kokhaie/Smart-Refrigerator-Demo/PCB/README.md

# PCB Bill of Materials

The KiCad-generated BOM is mirrored into the documentation site under `docs/` so it can be published through GitHub Pages.

- **Live BOM:** https://kokhaie.github.io/Smart-Refrigerator-Demo/bom.html
