kokhaie/Smart-Refrigerator-Demo/DataSheets/51OYClzEd8L._SL1000_.jpg

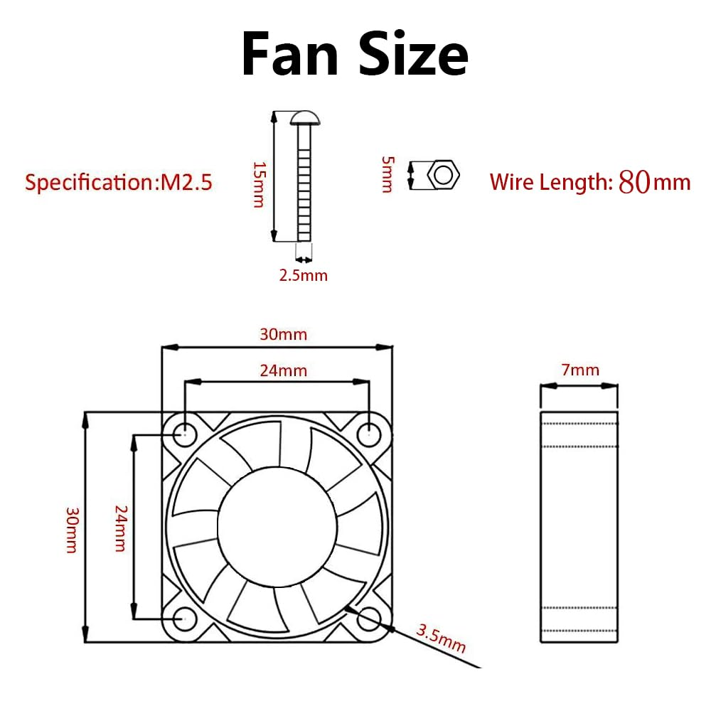
DataSheets/51OYClzEd8L._SL1000_.jpg
