kokhaie/Smart-Refrigerator-Demo/Firmware/components/lcd_manager/assets/images/mockups/lcd_dashboard.png

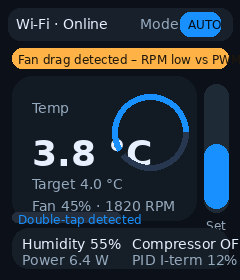
Firmware/components/lcd_manager/assets/images/mockups/lcd_dashboard.png
