kokhaie/Smart-Refrigerator-Demo/Firmware/components/lcd_manager/assets/images/mockups/lcd_landscape_home.png

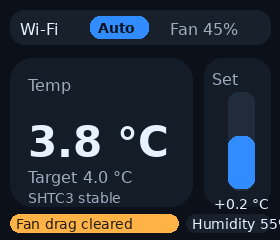
Firmware/components/lcd_manager/assets/images/mockups/lcd_landscape_home.png
