kokhaie/Smart-Refrigerator-Demo/Enclosure/front.dxf

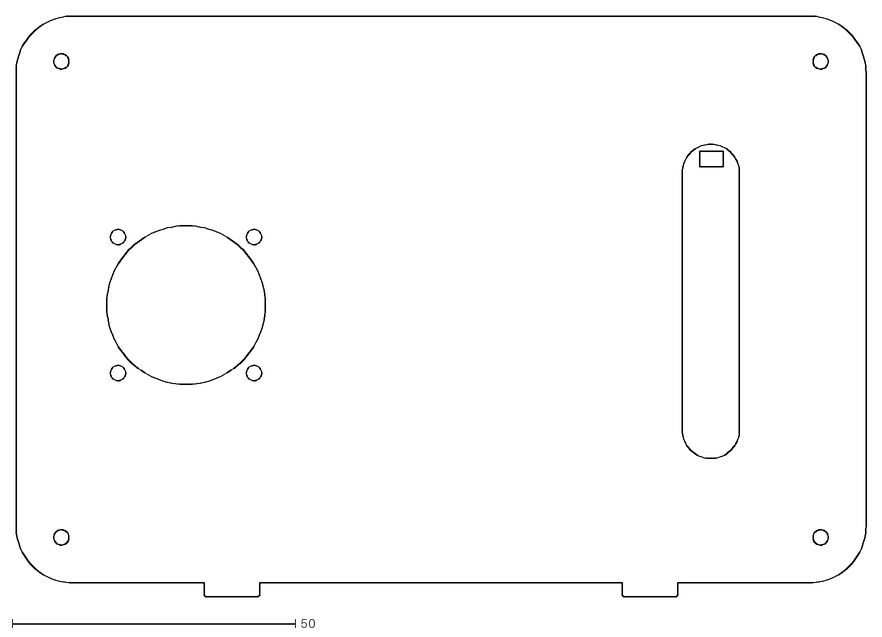
[picture p6: CAD file, 2025-10-21]
Enclosure/front.dxf
150.0 x 102.5
