kokhaie/Smart-Refrigerator-Demo/Enclosure/back.dxf

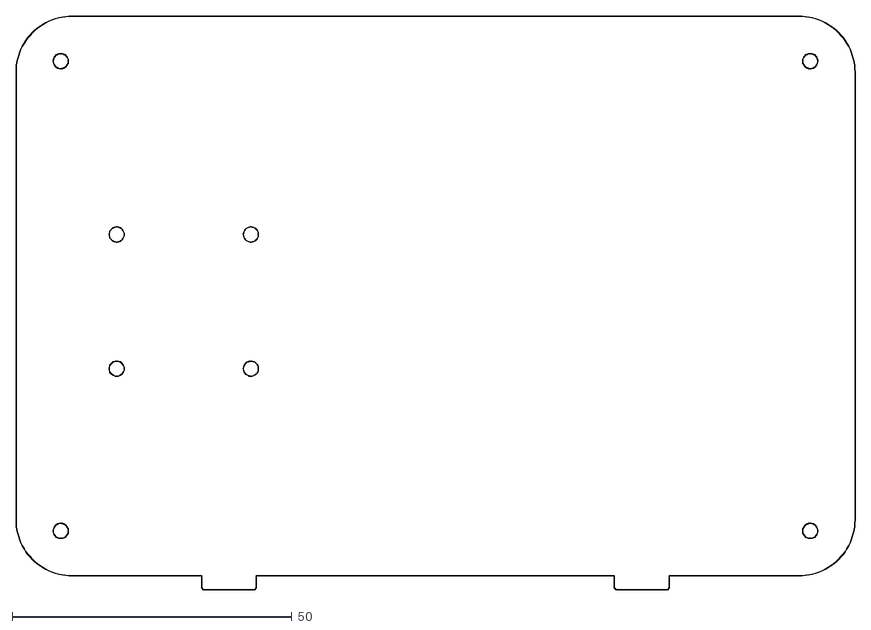
[picture p7: CAD file, 2025-10-21]
Enclosure/back.dxf
150.0 x 102.5
