kokhaie/Smart-Refrigerator-Demo/Enclosure/bottom.dxf

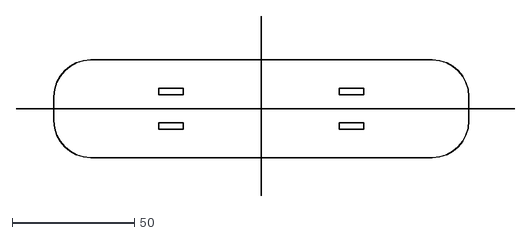
[picture p8: CAD file, 2025-10-21]
Enclosure/bottom.dxf
204.3 x 73.6
