kokhaie/Smart-Refrigerator-Demo/PCB/SmartCube.kicad_pcb

## KiCad design PCB/SmartCube.kicad_pcb (2025-09-15)

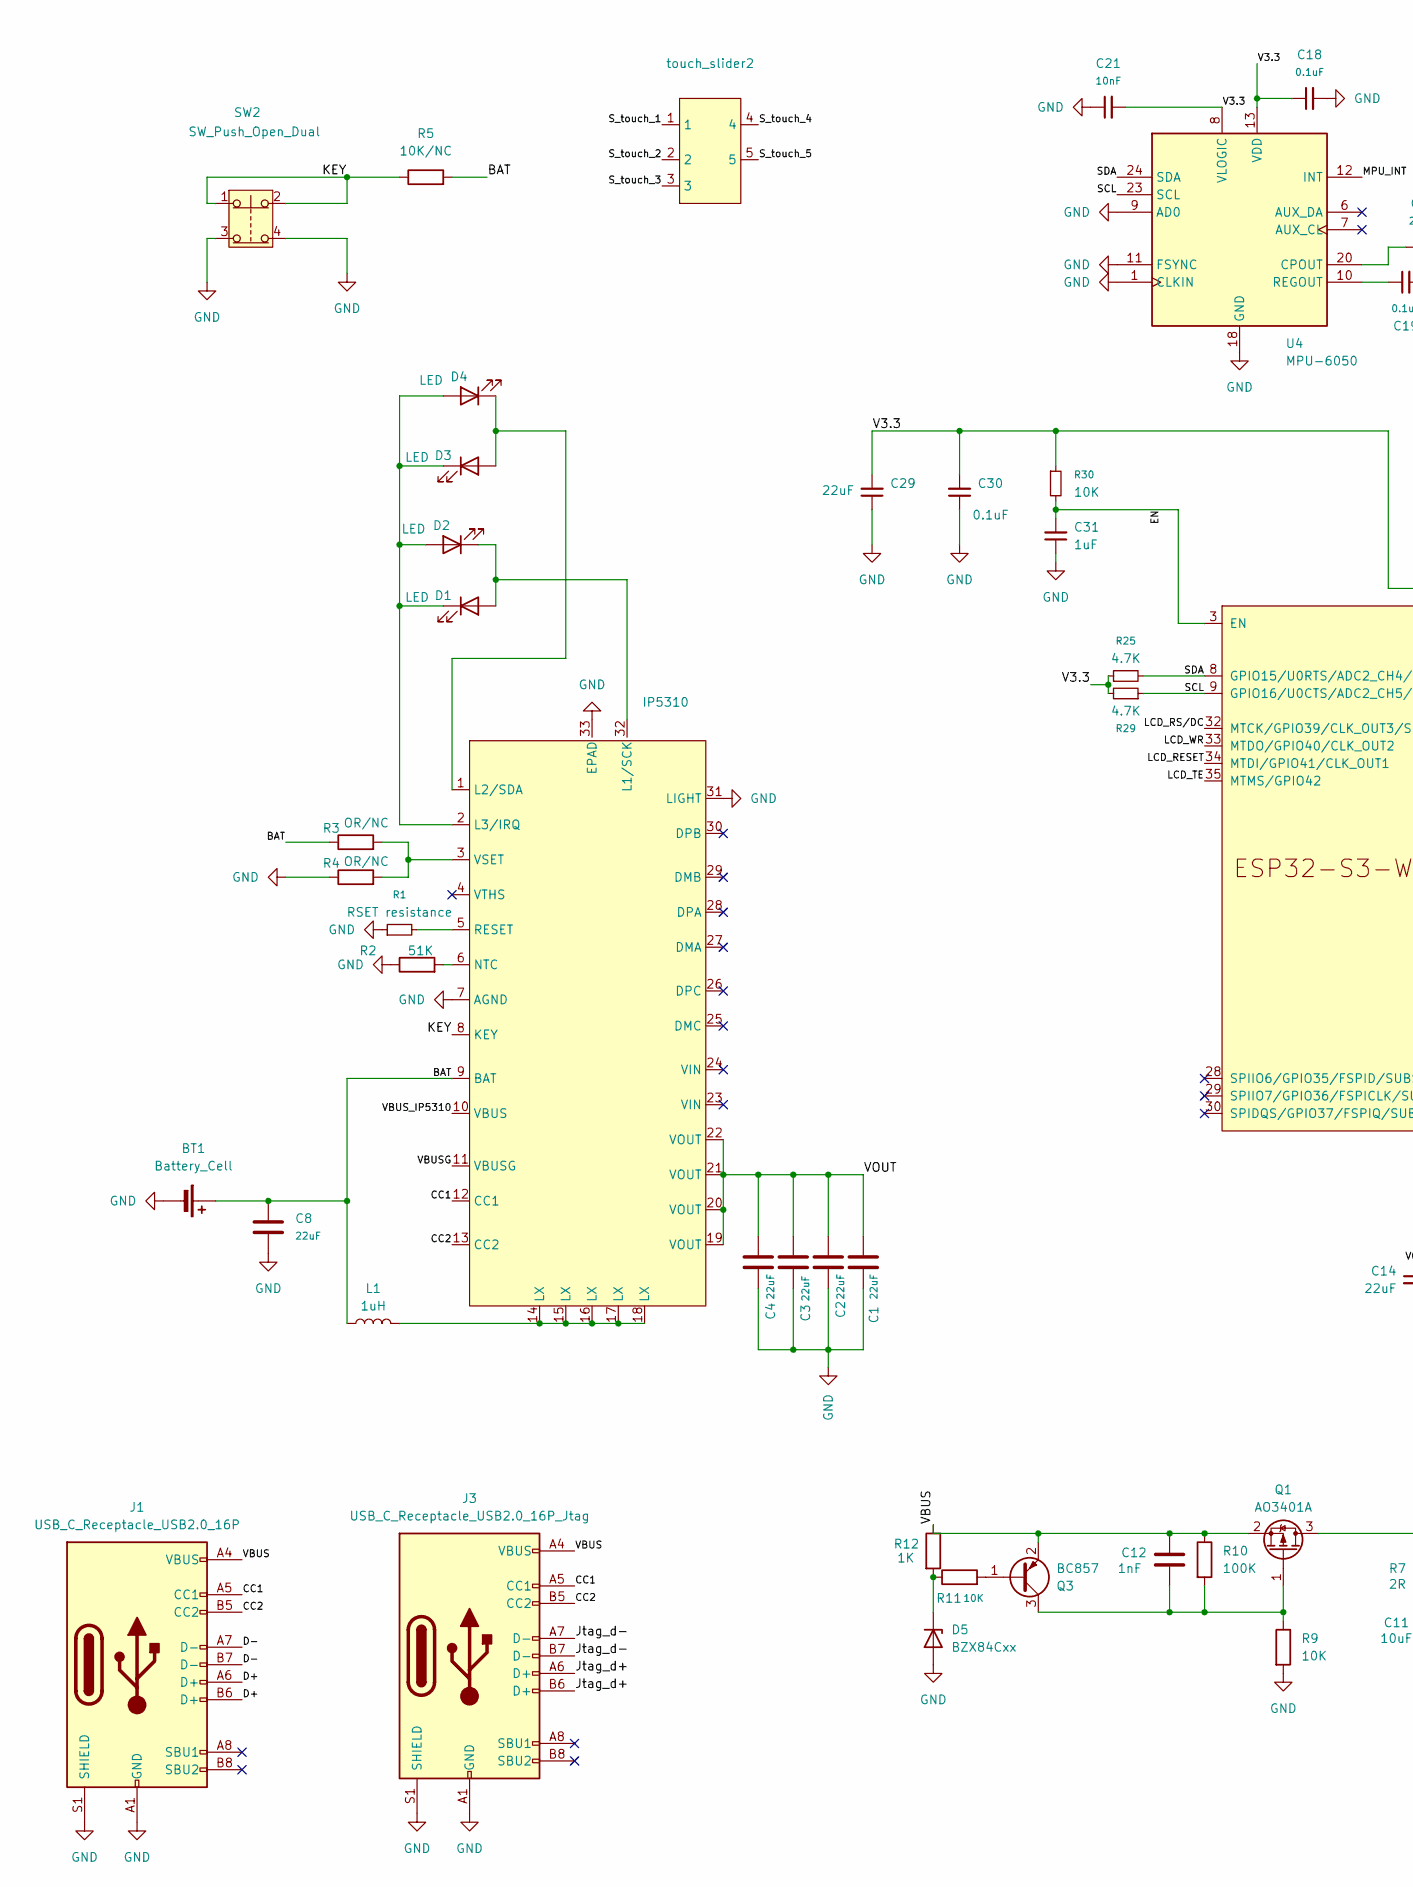
[picture p10: schematic SmartCube.kicad_sch, part in row 1, column 1]

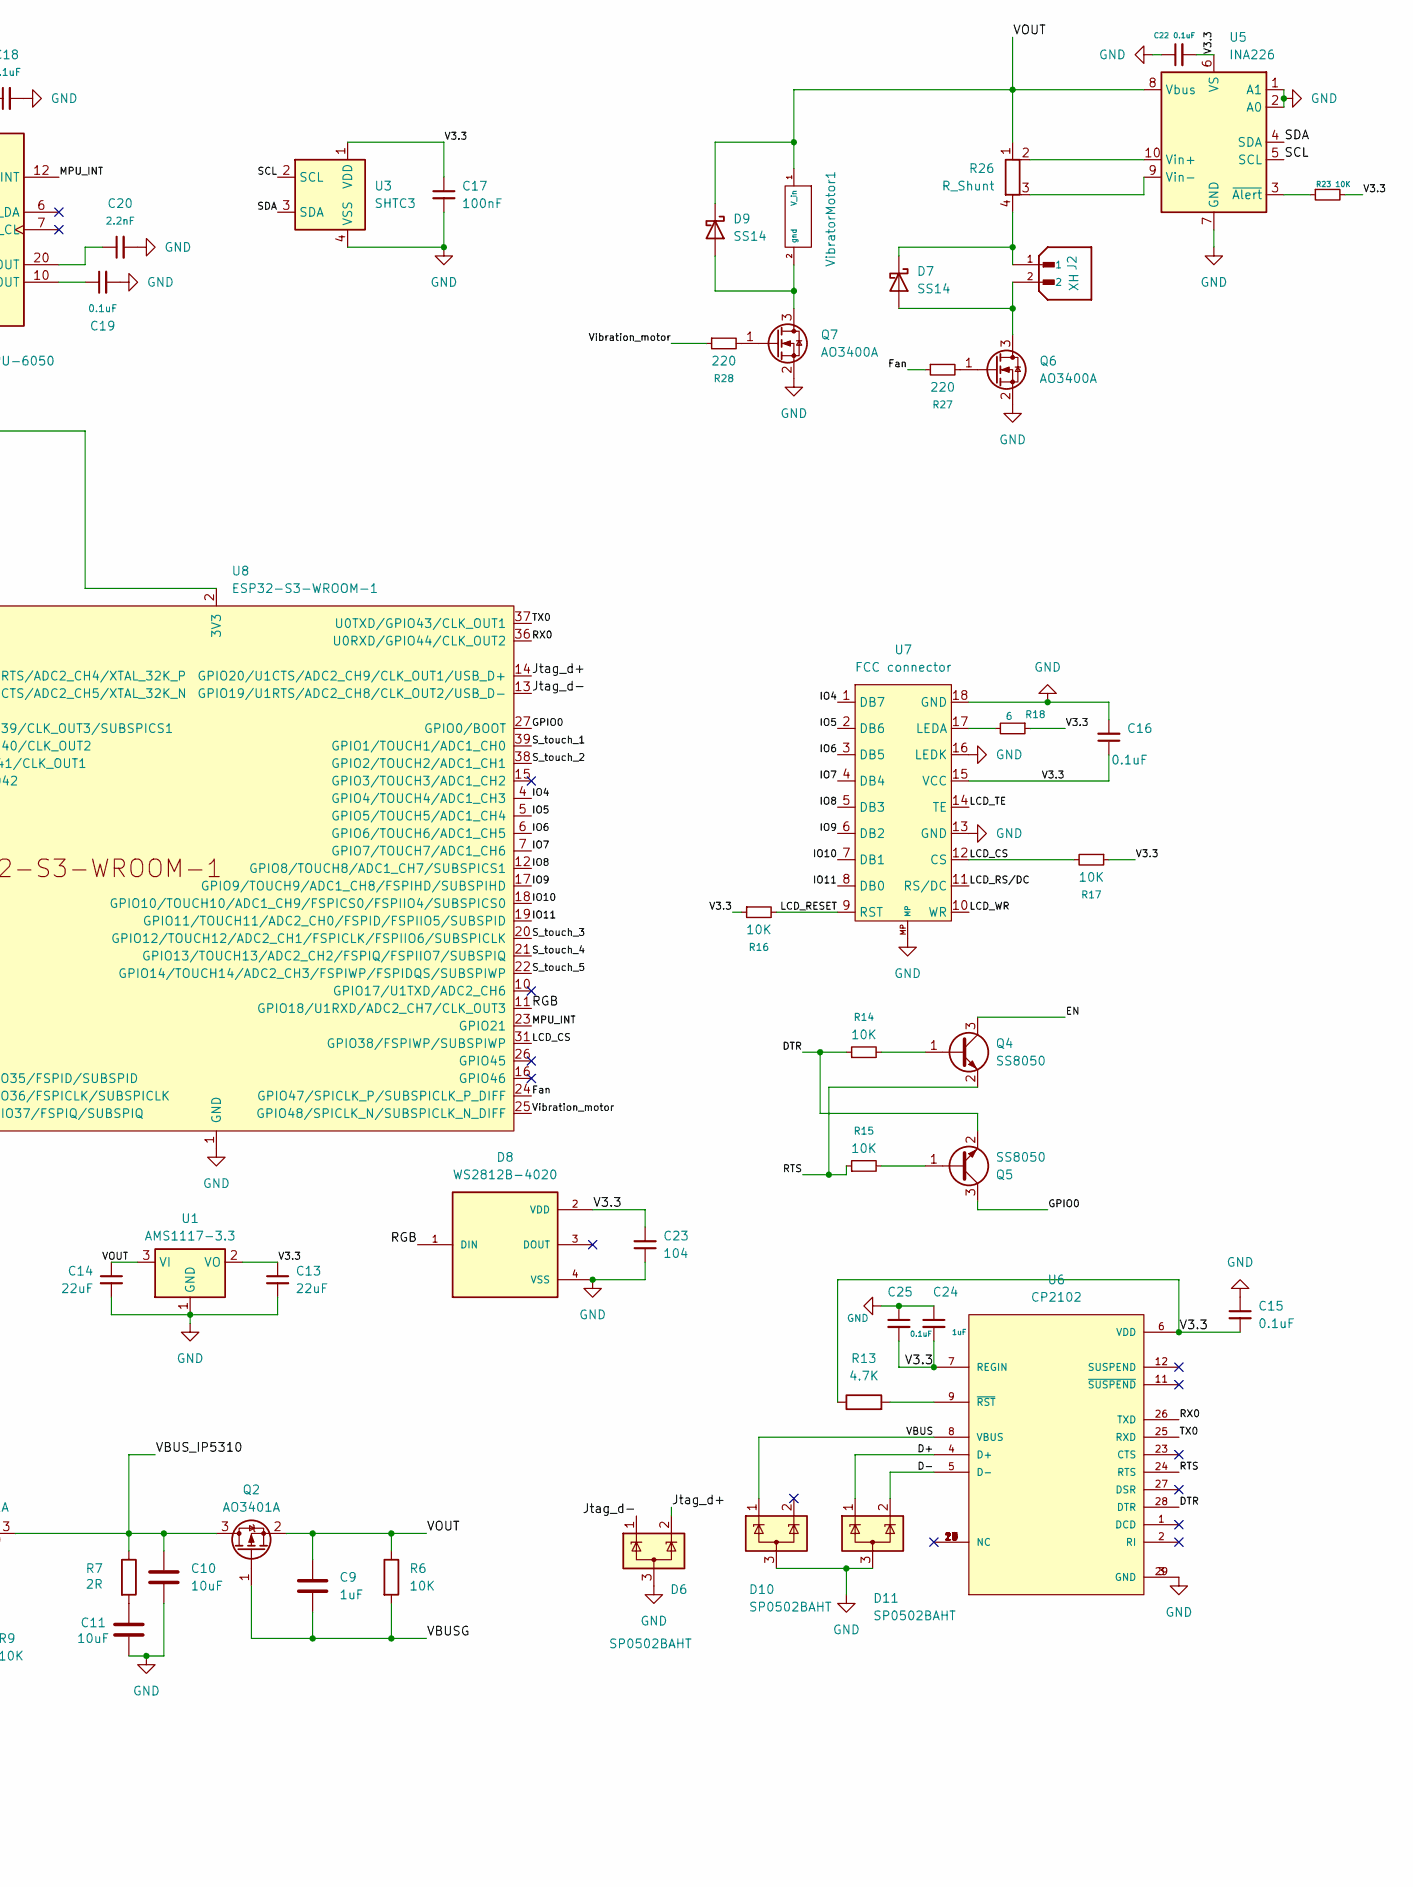
[picture p11: schematic SmartCube.kicad_sch, part in row 1, column 2]

Parts:
BT1: Battery_Cell; vibrator connector
C1, C2, C3, C4, C8, C13, C14: 22uF; C_0805_2012Metric
C9, C24, C31: 1uF; C_0805_2012Metric
C10, C11: 10uF; C_0805_2012Metric
C12: 1nF; C_0805_2012Metric
C15, C16, C18, C19, C22, C25, C30: 0.1uF; C_0805_2012Metric
C17: 100nF; C_0805_2012Metric
C20: 2.2nF; C_0805_2012Metric
C21: 10nF; C_0805_2012Metric
C23: 104; C_0805_2012Metric
C29: 22uF; CP_EIA-3528-21_Kemet-B
D1, D2, D3, D4: LED; LED_0603_1608Metric
D5: BZX84Cxx; SOT-23
D6, D10, D11: SP0502BAHT; SOT-23
D7, D9: SS14; D_SMA
D8: WS2812B-4020; LED_WS2812B-4020; PARTREV V1.2
IP5310: IP5310
J1: USB_C_Receptacle_USB2.0_16P; USB_C_Receptacle_GCT_USB4105-xx-A_16P_TopMnt_Horizontal
J2: XH; vibrator connector; PARTREV N/A
J3: USB_C_Receptacle_USB2.0_16P_Jtag; USB_C_Receptacle_GCT_USB4105-xx-A_16P_TopMnt_Horizontal
L1: 1uH; L_7.3x7.3_H4.5
Q1, Q2: AO3401A; SOT-23
Q3: BC857; SOT-23
Q4, Q5: SS8050; SOT-23
Q6, Q7: AO3400A; SOT-23
R1: RSET resistance; R_0805_2012Metric
R2: 51K; R_0603_1608Metric
R3, R4: OR/NC; R_0805_2012Metric
R5: 10K/NC; R_0805_2012Metric
R6, R9, R11, R14, R15, R16, R17, R23, R30: 10K; R_0805_2012Metric
R7: 2R; R_0805_2012Metric
R10: 100K; R_0805_2012Metric
R12: 1K; R_0805_2012Metric
R13, R25, R29: 4.7K; R_0805_2012Metric
R18: 6; R_0805_2012Metric
R26: R_Shunt; R_Shunt_Vishay_WSK2512_6332Metric_T1.19mm
R27, R28: 220; R_0805_2012Metric
SW2: SW_Push_Open_Dual; 1189UE
U1: AMS1117-3.3; SOT-223-3_TabPin2
U3: SHTC3; Sensirion_DFN-4-1EP_2x2mm_P1mm_EP0.7x1.6mm
U4: MPU-6050; InvenSense_QFN-24_4x4mm_P0.5mm
U5: INA226; VSSOP-10_3x3mm_P0.5mm
U6: CP2102; QFN50P500X500X100-29N
U7: FCC connector; Untitled
U8: ESP32-S3-WROOM-1
VibratorMotor1: vibrator connector
touch_slider2: TouchSlider-5_50x10mm

Connections:
/BAT: BT1.1 (+), C8.1, IP5310.9 (BAT), L1.1, R3.1, R5.2
/CC1: IP5310.12 (CC1), J1.A5 (CC1), J3.A5 (CC1)
/CC2: IP5310.13 (CC2), J1.B5 (CC2), J3.B5 (CC2)
/D+: D11.1 (K), J1.A6 (D+), J1.B6 (D+), U6.4 (D+)
/D-: D11.2 (K), J1.A7 (D-), J1.B7 (D-), U6.5 (D-)
/DTR: Q5.2 (E), R14.1, U6.28 (DTR)
/EN: C31.2, Q4.3 (C), R30.2, U8.3 (EN)
/Fan: R27.1, U8.24 (GPIO47/SPICLK_P/SUBSPICLK_P_DIFF)
/GPIO0: Q5.3 (C), U8.27 (GPIO0/BOOT)
/IO4: U7.1 (DB7), U8.4 (GPIO4/TOUCH4/ADC1_CH3)
/IO5: U7.2 (DB6), U8.5 (GPIO5/TOUCH5/ADC1_CH4)
/IO6: U7.3 (DB5), U8.6 (GPIO6/TOUCH6/ADC1_CH5)
/IO7: U7.4 (DB4), U8.7 (GPIO7/TOUCH7/ADC1_CH6)
/IO8: U7.5 (DB3), U8.12 (GPIO8/TOUCH8/ADC1_CH7/SUBSPICS1)
/IO9: U7.6 (DB2), U8.17 (GPIO9/TOUCH9/ADC1_CH8/FSPIHD/SUBSPIHD)
/IO10: U7.7 (DB1), U8.18 (GPIO10/TOUCH10/ADC1_CH9/FSPICS0/FSPIIO4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)
/IO11: U7.8 (DB0), U8.19 (GPIO11/TOUCH11/ADC2_CH0/FSPID/FSPIIO5/S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)
/Jtag_d+: D6.2 (K), J3.A6 (D+), J3.B6 (D+), U8.14 (GPIO20/U1CTS/ADC2_CH9/CLK_OUT1/USB_D+)
/Jtag_d-: D6.1 (K), J3.A7 (D-), J3.B7 (D-), U8.13 (GPIO19/U1RTS/ADC2_CH8/CLK_OUT2/USB_D-)
/KEY: IP5310.8 (KEY), R5.1, SW2.1, SW2.2
/LCD_CS: R17.2, U7.12 (CS), U8.31 (GPIO38/FSPIWP/SUBSPIWP)
/LCD_RESET: R16.2, U7.9 (RST), U8.34 (MTDI/GPIO41/CLK_OUT1)
/LCD_RS/DC: U7.11 (RS/DC), U8.32 (MTCK/GPIO39/CLK_OUT3/SUBSPICS1)
/LCD_TE: U7.14 (TE), U8.35 (MTMS/GPIO42)
/LCD_WR: U7.10 (WR), U8.33 (MTDO/GPIO40/CLK_OUT2)
/MPU_INT: U4.12 (INT), U8.23 (GPIO21)
/RGB: D8.1 (DIN), U8.11 (GPIO18/U1RXD/ADC2_CH7/CLK_OUT3); also elsewhere on the board
/RTS: Q4.2 (E), R15.1, U6.24 (RTS)
/RX0: U6.26 (TXD), U8.36 (U0RXD/GPIO44/CLK_OUT2)
/SCL: R29.1, U3.2 (SCL), U4.23 (SCL), U5.5 (SCL), U8.9 (GPIO16/U0CTS/ADC2_CH5/XTAL_32K_N)
/SDA: R25.2, U3.3 (SDA), U4.24 (SDA), U5.4 (SDA), U8.8 (GPIO15/U0RTS/ADC2_CH4/XTAL_32K_P)
/S_touch_1: U8.39 (GPIO1/TOUCH1/ADC1_CH0), touch_slider2.1
/S_touch_2: U8.38 (GPIO2/TOUCH2/ADC1_CH1), touch_slider2.2
/S_touch_3: U8.20 (GPIO12/TOUCH12/ADC2_CH1/FSPICLK/FSPIIO6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), touch_slider2.3
/S_touch_4: U8.21 (GPIO13/TOUCH13/ADC2_CH2/FSPIQ/FSPIIO7/S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), touch_slider2.4
/S_touch_5: U8.22 (GPIO14/TOUCH14/ADC2_CH3/FSPIWP/FSPIDQS/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), touch_slider2.5
/TX0: U6.25 (RXD), U8.37 (U0TXD/GPIO43/CLK_OUT1)
/V3.3: C13.1, C15.2, C16.1, C17.1, C18.1, C21.2, C22.2, C23.2, C24.2, C25.2, C29.2, C30.2, D8.2 (VDD), R13.1, R16.1, R17.1, R18.1, R23.2, R25.1, R29.2, R30.1, U1.2 (VO), U3.1 (VDD), U4.8 (VLOGIC), U4.13 (VDD), U5.6 (VS), U6.6 (VDD), U6.7 (REGIN), U7.15 (VCC), U8.2 (3V3); also elsewhere on the board
/VBUS: C12.1, D10.1 (K), J1.A4 (VBUS), J1.A9 (VBUS), J1.B4 (VBUS), J1.B9 (VBUS), J3.A4 (VBUS), J3.A9 (VBUS), J3.B4 (VBUS), J3.B9 (VBUS), Q1.2 (S), Q3.2 (E), R10.1, R12.1, U6.8 (VBUS)
/VBUSG: C9.2, IP5310.11 (VBUSG), Q2.1 (G), R6.2
/VBUS_IP5310: C10.1, IP5310.10 (VBUS), Q1.3 (D), Q2.3 (D), R7.1
/VOUT: C1.1, C2.1, C3.1, C4.1, C9.1, C14.1, D9.1 (K), IP5310.19 (VOUT), IP5310.20 (VOUT), IP5310.21 (VOUT), IP5310.22 (VOUT), Q2.2 (S), R6.1, R26.1, U1.3 (VI), U5.8 (Vbus), VibratorMotor1.1 (V_in)
/Vibration_motor: R28.1, U8.25 (GPIO48/SPICLK_N/SUBSPICLK_N_DIFF)
GND: BT1.2 (-), C1.2, C2.2, C3.2, C4.2, C8.2, C10.2, C11.2, C13.2, C14.2, C15.1, C16.2, C17.2, C18.2, C19.2, C20.2, C21.1, C22.1, C23.1, C24.1, C25.1, C29.1, C30.1, C31.1, D5.1 (A), D6.3 (A), D8.4 (VSS), D10.3 (A), D11.3 (A), IP5310.7 (AGND), IP5310.31 (LIGHT), IP5310.33 (EPAD), J1.A1 (GND), J1.A12 (GND), J1.B1 (GND), J1.B12 (GND), J1.S1 (SHIELD), J3.A1 (GND), J3.A12 (GND), J3.B1 (GND), J3.B12 (GND), J3.S1 (SHIELD), Q6.2 (S), Q7.2 (S), R1.1, R2.1, R4.1, R9.2, SW2.3, SW2.4, U1.1 (GND), U3.4 (VSS), U4.1 (CLKIN), U4.9 (AD0), U4.11 (FSYNC), U4.18 (GND), U5.1 (A1), U5.2 (A0), U5.7 (GND), U6.3 (GND), U6.29 (GND), U7.13 (GND), U7.16 (LEDK), U7.18 (GND), U7.MP, U8.1 (GND), U8.40 (GND), U8.41 (GND); also elsewhere on the board
unnamed: C11.1, R7.2
unnamed: D1.2 (A), D2.1 (K), IP5310.32 (L1/SCK)
unnamed: D1.1 (K), D2.2 (A), D3.1 (K), D4.2 (A), IP5310.2 (L3/IRQ)
unnamed: D3.2 (A), D4.1 (K), IP5310.1 (L2/SDA)
unnamed: D5.3 (K), R11.1, R12.2
unnamed: D7.2 (A), J2.2, Q6.3 (D)
unnamed: D7.1 (K), J2.1, R26.4
unnamed: D9.2 (A), Q7.3 (D), VibratorMotor1.2 (gnd)
unnamed: IP5310.14 (LX), IP5310.15 (LX), IP5310.16 (LX), IP5310.17 (LX), IP5310.18 (LX), L1.2
unnamed: IP5310.6 (NTC), R2.2
unnamed: IP5310.5 (RESET), R1.2
unnamed: IP5310.3 (VSET), R3.2, R4.2
unnamed: C12.2, Q1.1 (G), Q3.3 (C), R9.1, R10.2
unnamed: Q3.1 (B), R11.2
unnamed: Q4.1 (B), R14.2
unnamed: Q5.1 (B), R15.2
unnamed: Q6.1 (G), R27.2
unnamed: Q7.1 (G), R28.2
unnamed: C20.1, U4.20 (CPOUT)
unnamed: C19.1, U4.10 (REGOUT)
unnamed: R26.2, U5.10 (Vin+)
unnamed: R26.3, U5.9 (Vin-)
unnamed: R23.1, U5.3 (~Alert)
unnamed: R13.2, U6.9 (~RST)
unnamed: R18.2, U7.17 (LEDA)

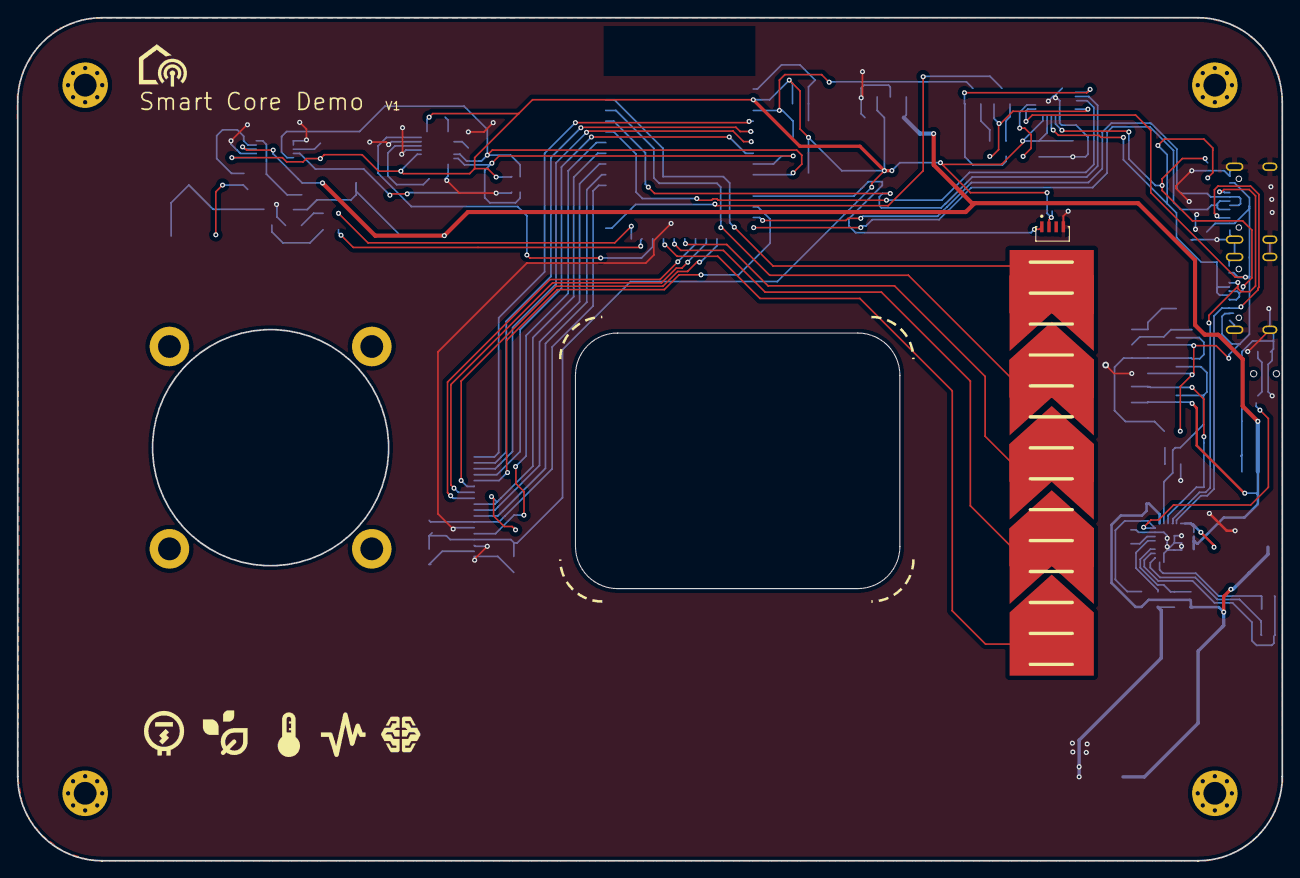
[picture p12: board SmartCube.kicad_pcb from above]

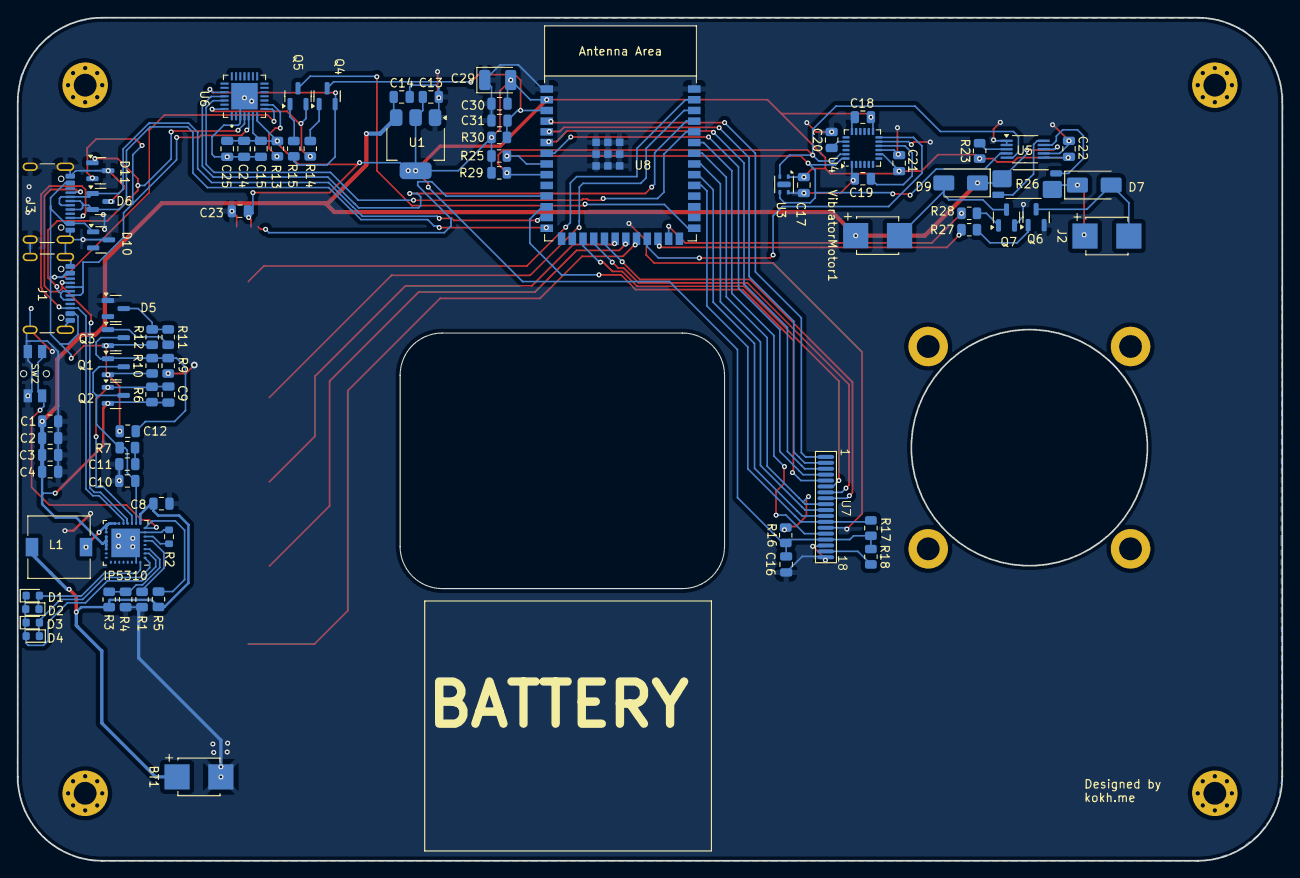
[picture p13: board SmartCube.kicad_pcb from below]

Board: 2 copper layers, 150.0 x 100.0 mm, 83 parts (81 on the bottom side), 69 nets.

Other parts of the board:
RGB: WS2812B-4020; LED_WS2812B-4020

Their connections:
/RGB: RGB.1 (DIN); also elsewhere on the board
/V3.3: RGB.2 (VDD); also elsewhere on the board
GND: RGB.4 (VSS); also elsewhere on the board
