kokhaie/Smart-Refrigerator-Demo/(commit log)

2025-09-05 First Schema Version
    [SmartCube.kicad_pcb, SmartCube.kicad_sch]
2025-09-05 Update Schema and add SP0502BAHAT
    [SmartCube.kicad_sch]
2025-09-06 Add footprints to schema
    [SmartCube.kicad_sch]
2025-09-07 Add first version of pcb
    [SmartCube.kicad_pcb, SmartCube.kicad_sch]
2025-09-08 Initialize first pcb version
    [SmartCube.kicad_pcb, SmartCube.kicad_sch]
2025-09-15 Add jtag USB
    [SmartCube.kicad_pcb, SmartCube.kicad_sch]
2025-09-20 Add motors component
2025-09-23 feat(network): add mqtt broker and implement non blocking wifi connection
    [main.c]
2025-09-25 feat(network): Add local broker and wifi management
    [main.c, motors.c, sensor_manager.c, sensor_manager.h]
2025-09-25 fix(ui): Update lcd driver
2025-10-03 Comment out sensor init
2025-10-03 add sensor Kconfig
2025-10-04 feat(sensor): Add fifo(mpu6050)
2025-10-04 fix(sensor): add delay end of the loop of reading sensors
    [sensor_manager.c]
2025-10-06 fix(ui): Fix i80 controller driver misconfig
2025-10-11 fix(sensor): Pack the sensor data
    [sensor_manager.c]
2025-10-12 feat(sensor_manager): add sensor acquisition and synchronization - Support MPU6050 (FIFO + interrupt-driven reads), INA226, and SHTC3 - Protect shared state with mutexes - Provide stream queue (drop-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
2025-10-12 feat(data_publisher): implement MQTT publishing for sensors - Publish real-time stream at 10Hz (device/realtime/samples) - Publish batch data as JSON arrays (device/training/samples) - Add slider set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
    [data_publisher.c, data_publisher.h]
2025-10-12 feat(network_manager): support remote broker and fallback AP mode - Wi-Fi STA connects to remote broker with retries + timeout - On failure, switch to AP mode and run embedded MQTT broker - Introduce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
2025-10-12 refactor(main): wire up sensor manager, publisher, and business logic - Start all core components in app_main - Run tasks pinned to appropriate cores for performance
2025-10-13 feat(business_logic): add deadband and integral decay for stable fan control
    ### Why
    - The fan was staying at a low duty cycle (e.g. ~10%) indefinitely once the system
    reached the setpoint, due to integral windup.
    - Small temperature fluctuations caused unnecessary fan activity.
    ### What
    - Introduced a ±0.5 °C deadband around the setpoint to ignore tiny fluctuations.
    - Added integral decay when below setpoint so the fan ramps down smoothly.
    - Applied a low-duty cutoff to fully switch off the fan below threshold.
    ### Impact
    - Prevents fan from running forever at low duty.
    - Improves stability and energy efficiency.
    - Mimics real fridge hysteresis behavior.
    [main.c, motors.c, sensor_manager.c]
2025-10-14 feat: add LED manager component with basic UI modes and startup animation
    - Created new led_manager component to handle WS2812B LED control
    - Implemented LED modes:
    • NORMAL mode → shows setpoint as solid color mapped to temperature range
    • ECO mode → green indicator
    • SUPERCOOL mode → blue indicator
    • ERROR mode → red indicator
    • OFF mode → turns all LEDs off
    - Added rainbow animation for initialization / internet-connecting state
    • Automatically stops once system connects to internet
    • Falls back to rainbow if disconnected
    - Implemented smooth brightness updates with diffuser in mind
    - Added public API:
    • led_manager_init()
    • led_manager_set_mo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
    [led_manager.c, led_manager.h]
2025-10-16 fix(ui_controller):Update bussiness logic setpoint temp using touch slider
    [main.c]
2025-10-16 Add plexi enclosure box design
    [back.dxf, bottom.dxf, front.dxf]
2025-10-17 fix(lcd_manager):Rotate screen 270 degree
    [lcd_manager.c]
2025-10-21 feat(ui): reorganize lcd manager and add smart/eco/rapid modes
    - restructure lcd_manager into src/ui/assets and fix CMake paths
    - add Smart/Eco/Rapid mode profiles across business logic and UI
    - update LCD badge defaults and generated assets to match new layout
    - widen slider margins so touch gestures don’t pin the physical edges
    [lcd_manager.c]
2025-10-28 Add PCB BOM
